RuhejamiM/hand-hygiene-device/README.md

# hand-hygiene-device 
A device that encourages children to wash their hands through play to foster independence as a skill and reward good hygiene habits.

Ethan Bonpin (@eb3326; eb3326@nyu.edu) and Ruhejami Mustari (@RuhejamiM; rm4966@nyu.edu)
