RuhejamiM/hand-hygiene-device/Documentation/Physical Interface.pdf

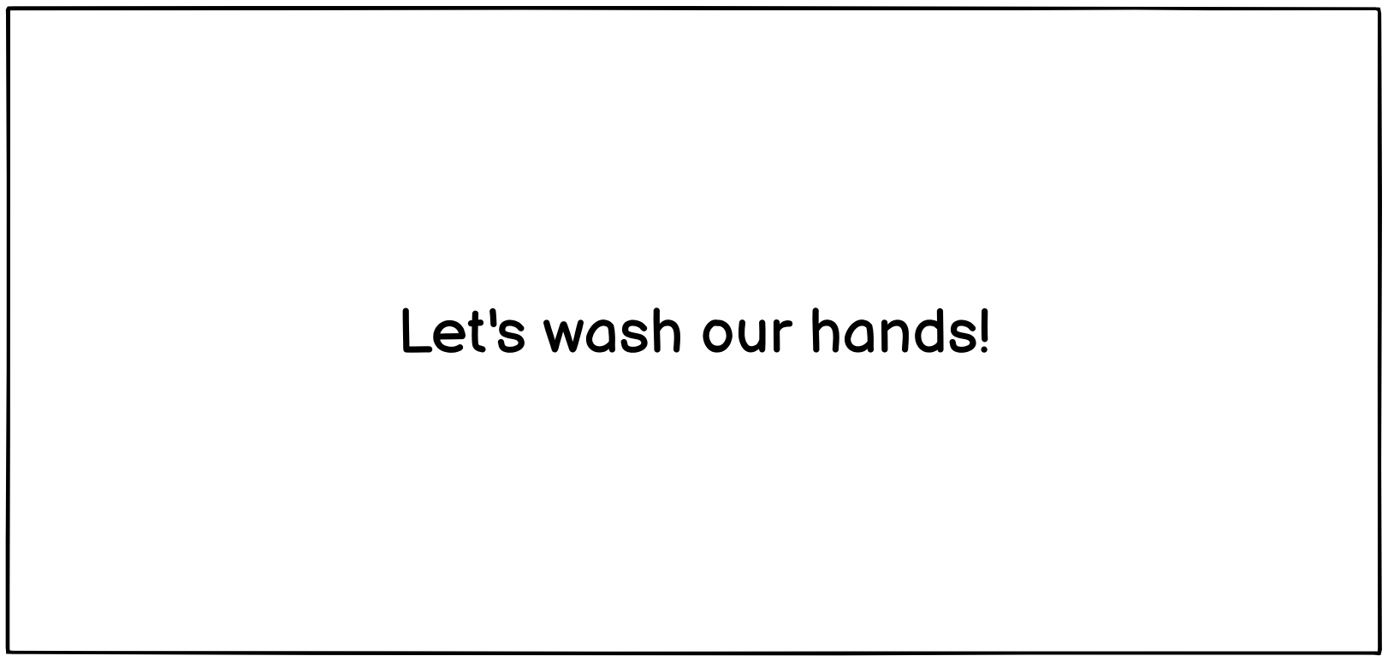
[picture p1: figure]
Let's wash our hands!

Settings

Scroll

Select

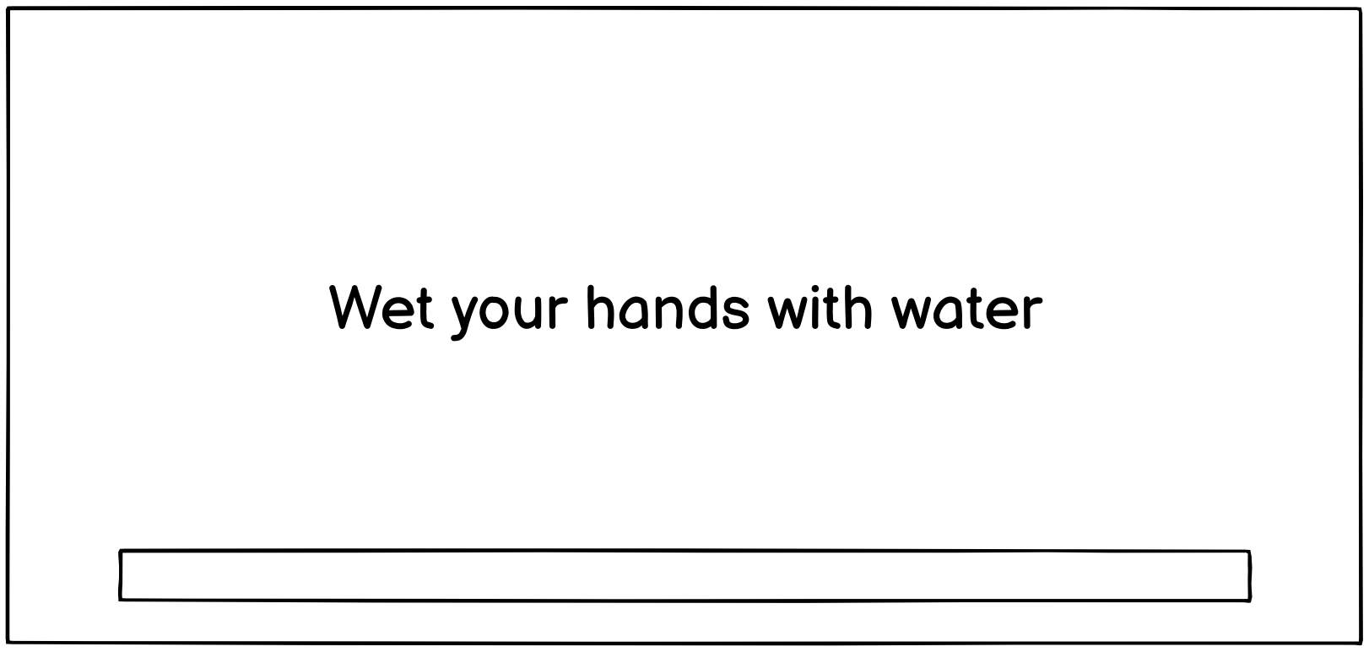
[picture p2: figure]
Wet your hands with water

Scroll

Select

Settings

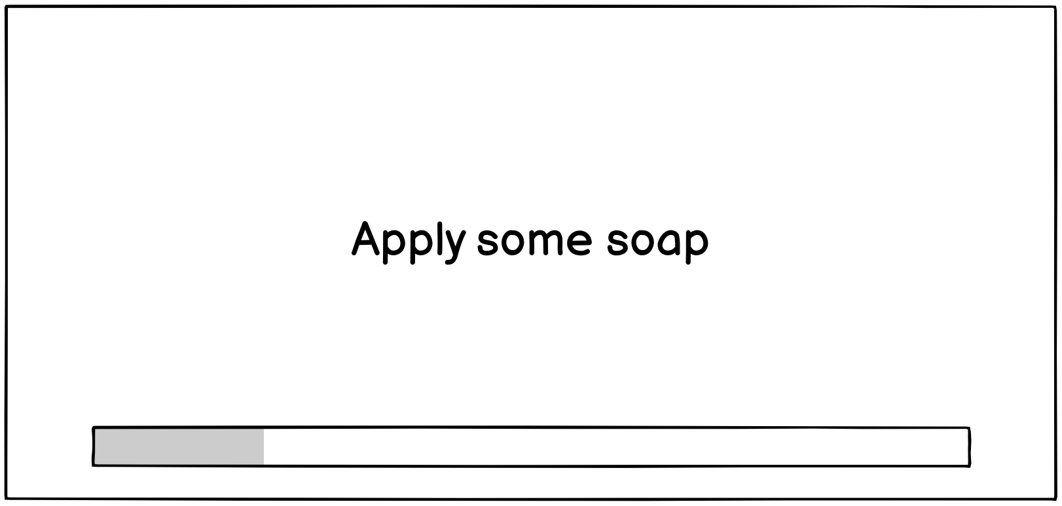
[picture p3: figure]
Apply some soap

Scroll

Select

Settings

Scroll

Select

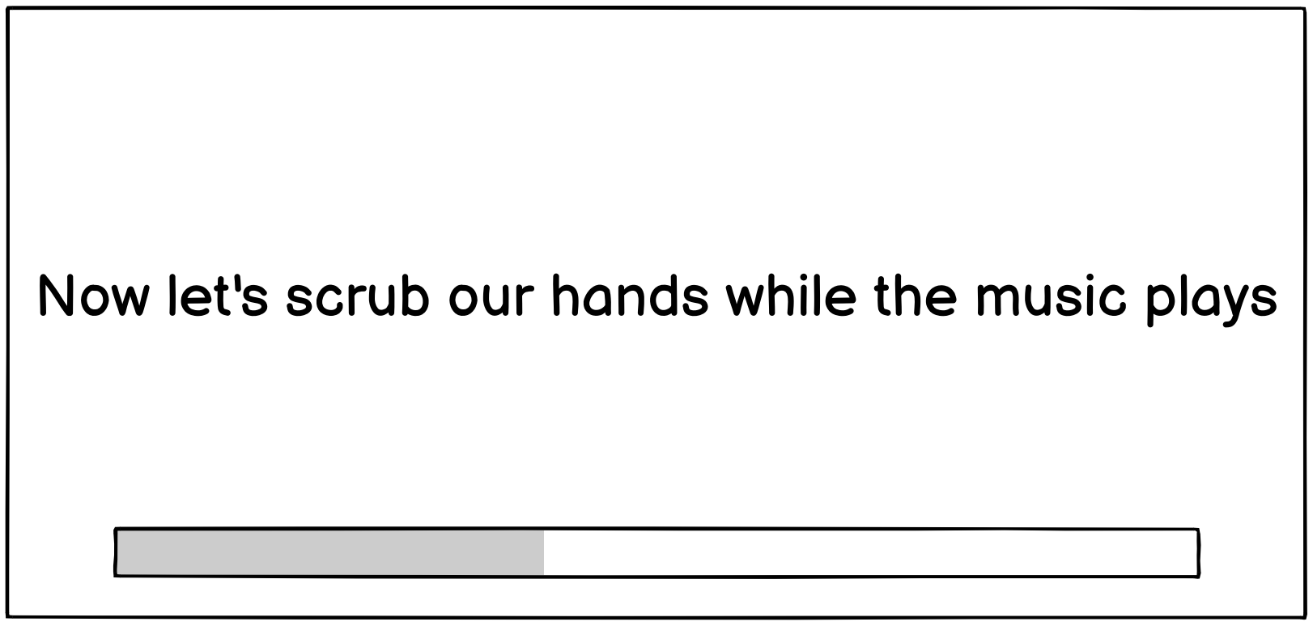
[picture p4: figure]

Now let's scrub our hands while the music plays

Settings

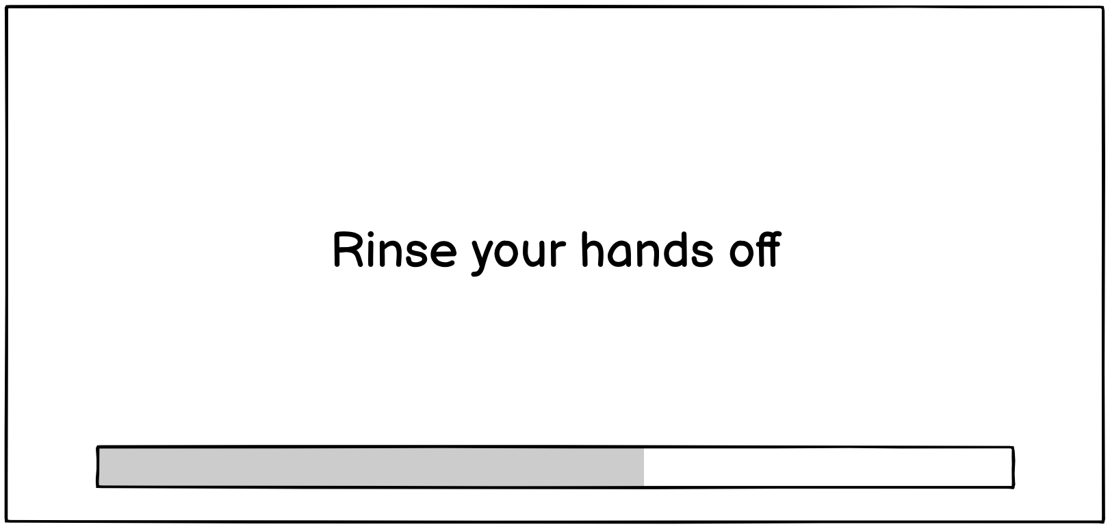
[picture p5: figure]
Rinse your hands off

Scroll

Select

Settings

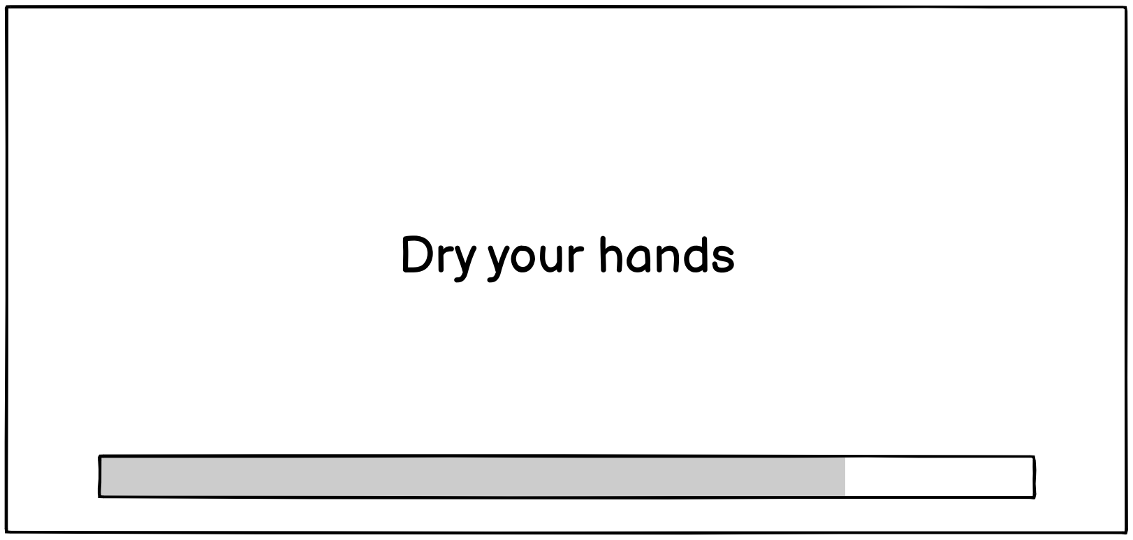
[picture p6: figure]
Dry your hands

Scroll

Select

Settings

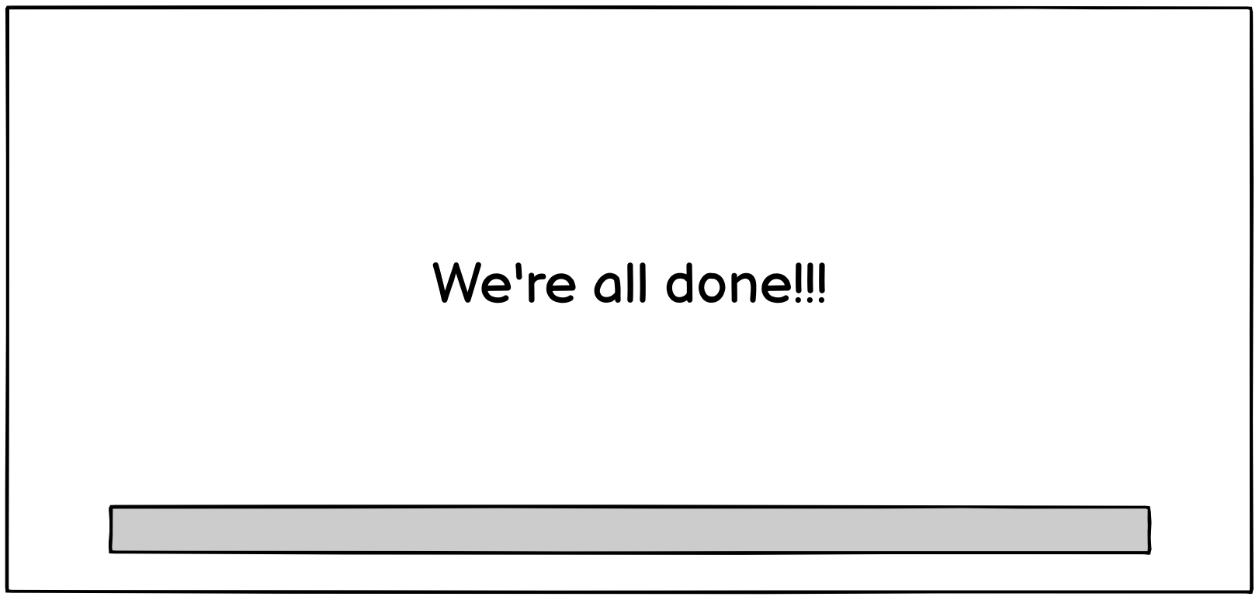
[picture p7: figure]
We're all done!!!

Scroll

Select

Settings

Scroll

Select

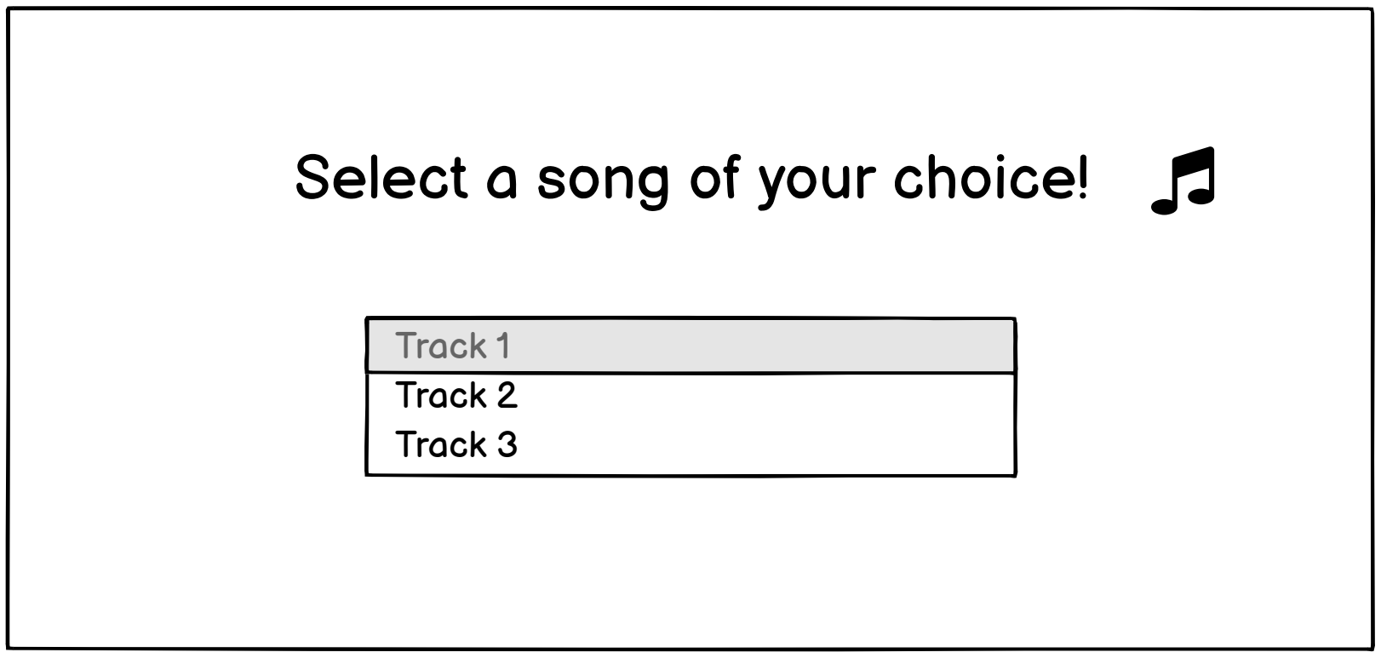
[picture p8: figure]
Track 1 Track 2 Track 3

Settings | Select a song of your choice!

Scroll

Select

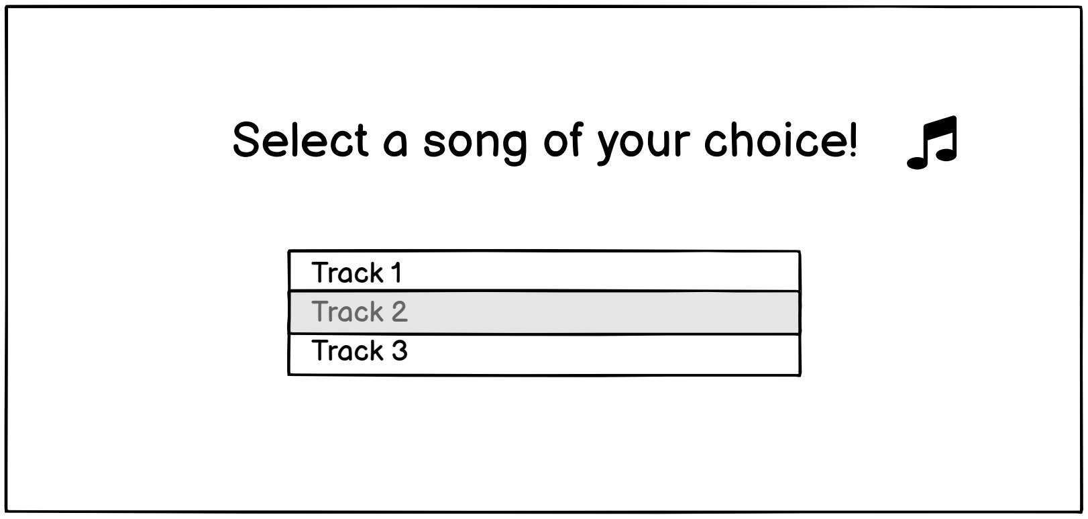
[picture p9: figure]
Track 1 Track 2 Track 3

Settings | Select a song of your choice!

Scroll

Select

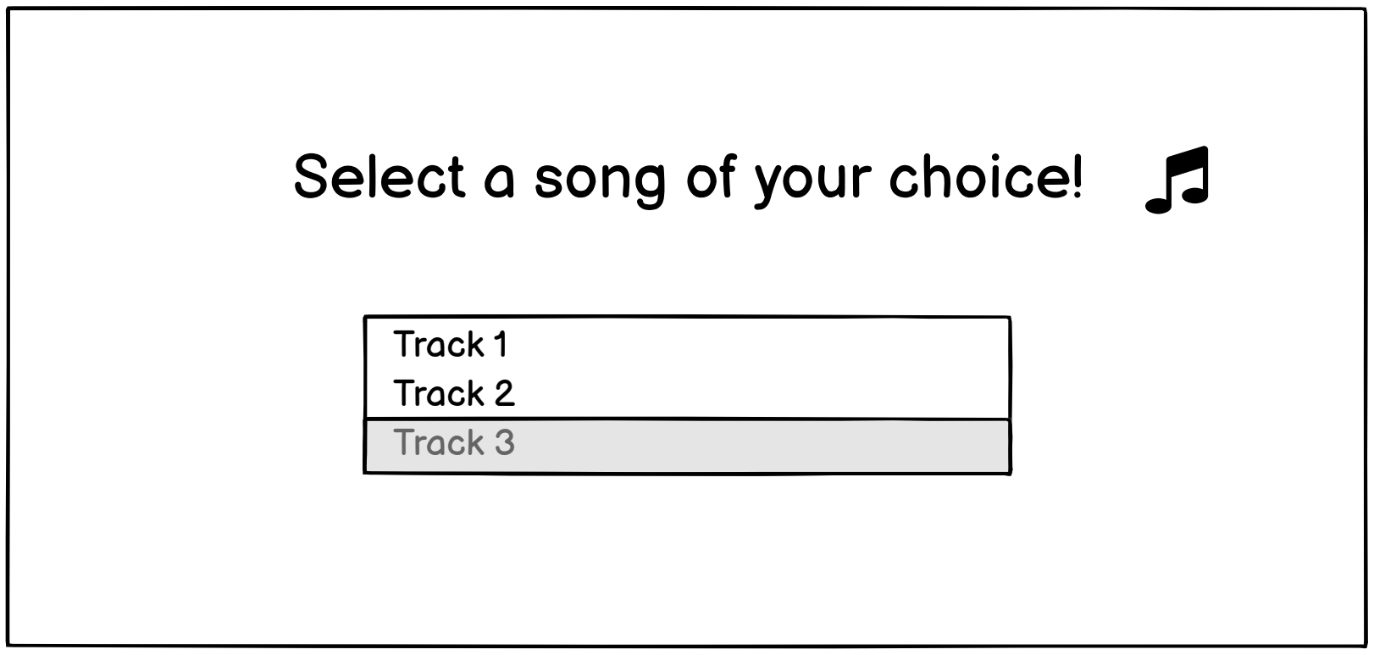
[picture p10: figure]
Track 1 Track 2 Track 3

Settings | Select a song of your choice!
