RuhejamiM/hand-hygiene-device/img/dry_hands.png

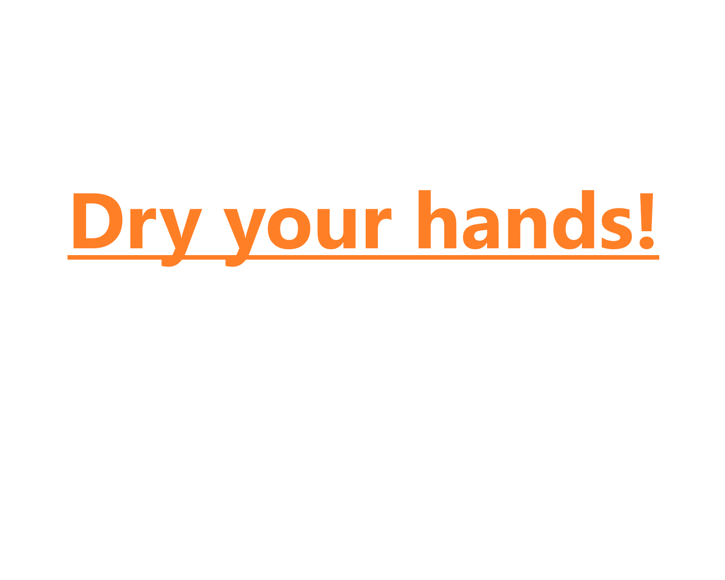
img/dry_hands.png
