RuhejamiM/hand-hygiene-device/img/finished.png

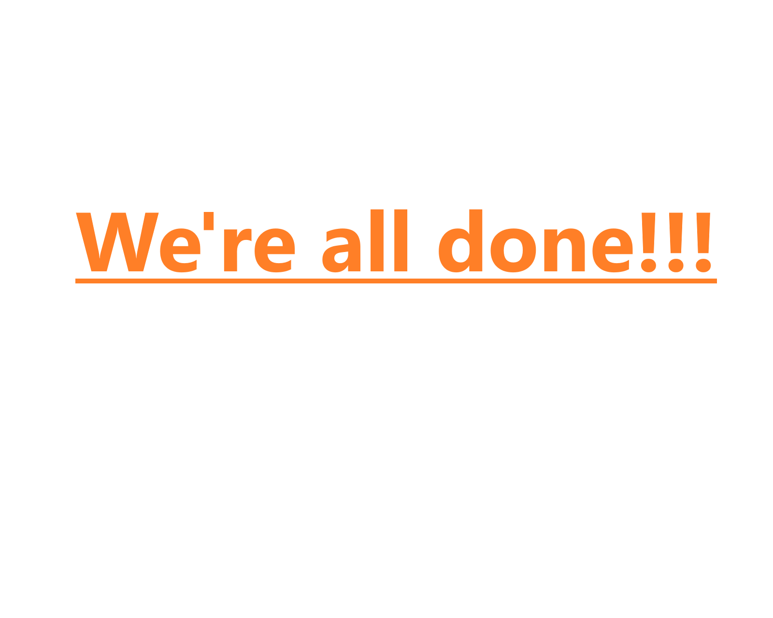
img/finished.png
