RuhejamiM/hand-hygiene-device/img/rinse_hands.png

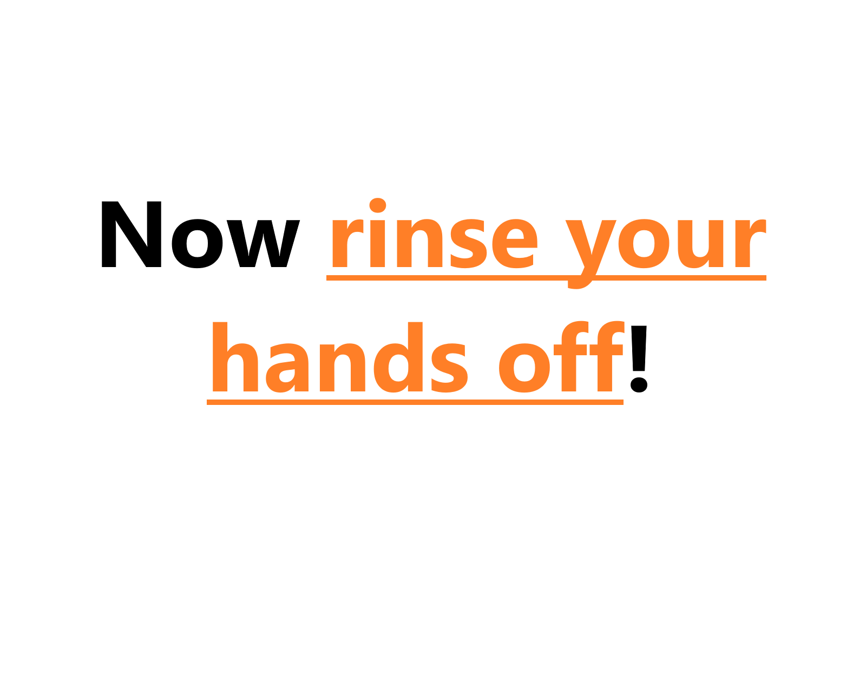
img/rinse_hands.png
