RuhejamiM/hand-hygiene-device/img/scrub_hands.png

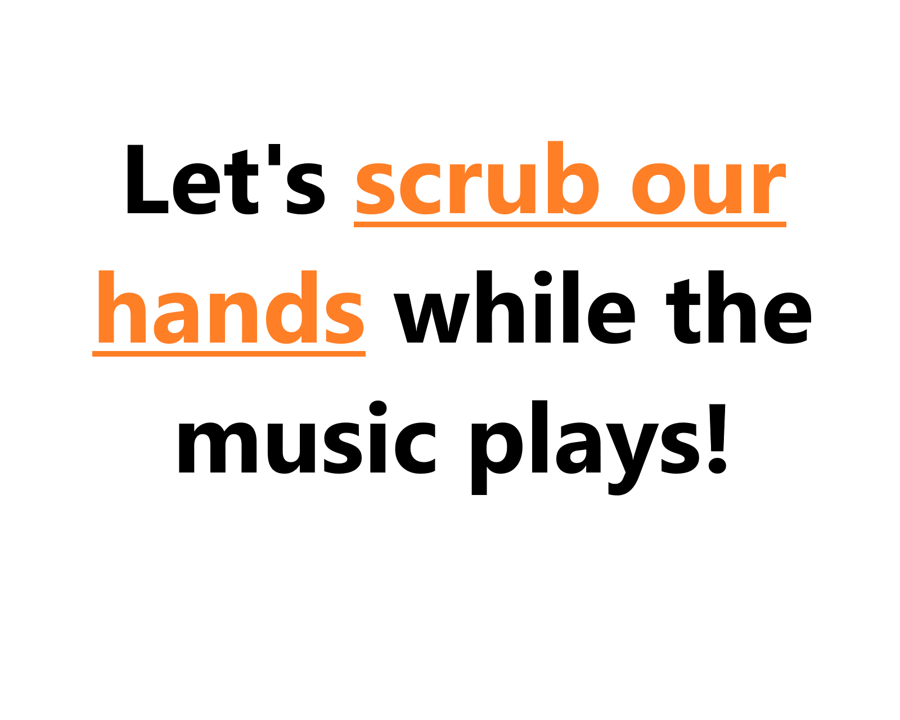
img/scrub_hands.png
