RuhejamiM/hand-hygiene-device/img/settings_main.png

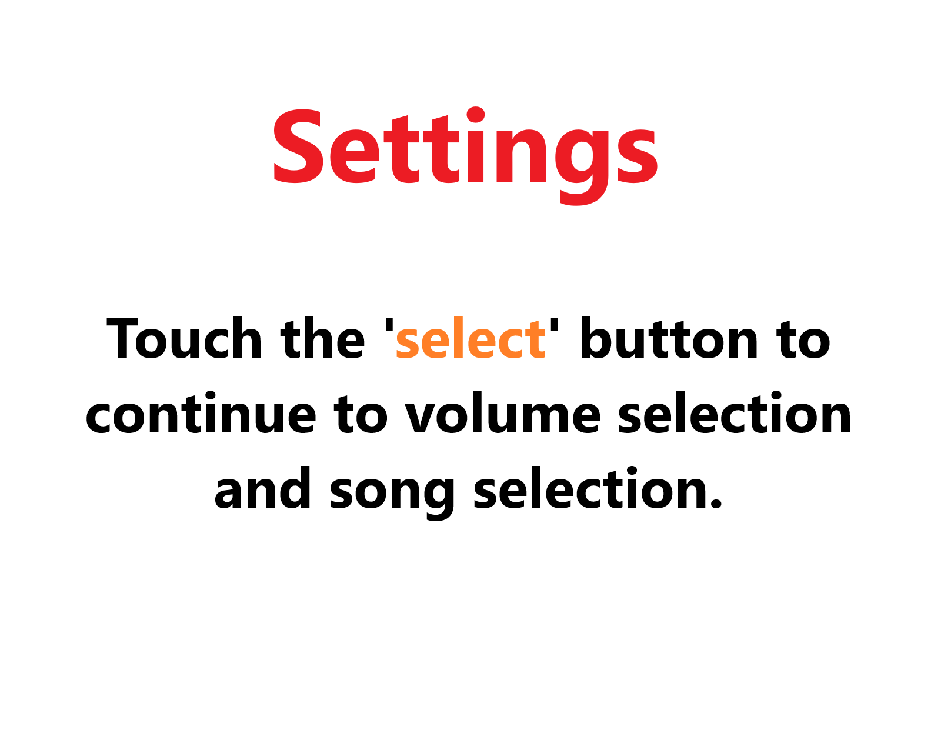
img/settings_main.png
