RuhejamiM/hand-hygiene-device/img/settings_songchoice.png

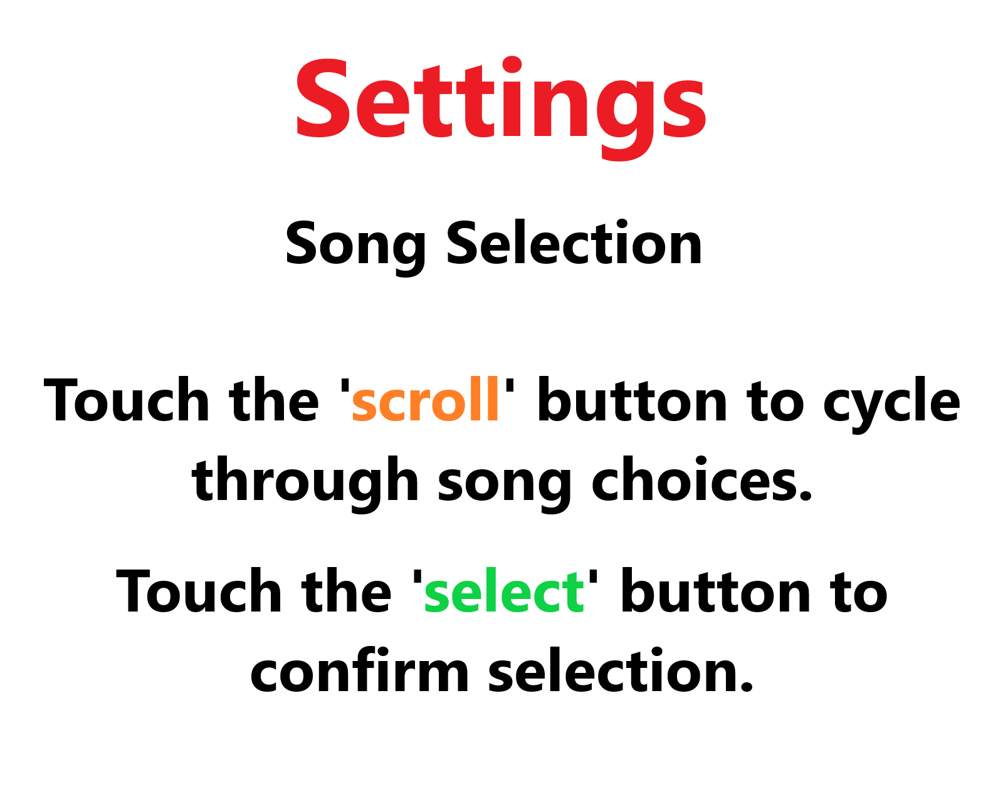
img/settings_songchoice.png
