RuhejamiM/hand-hygiene-device/img/settings_volume.png

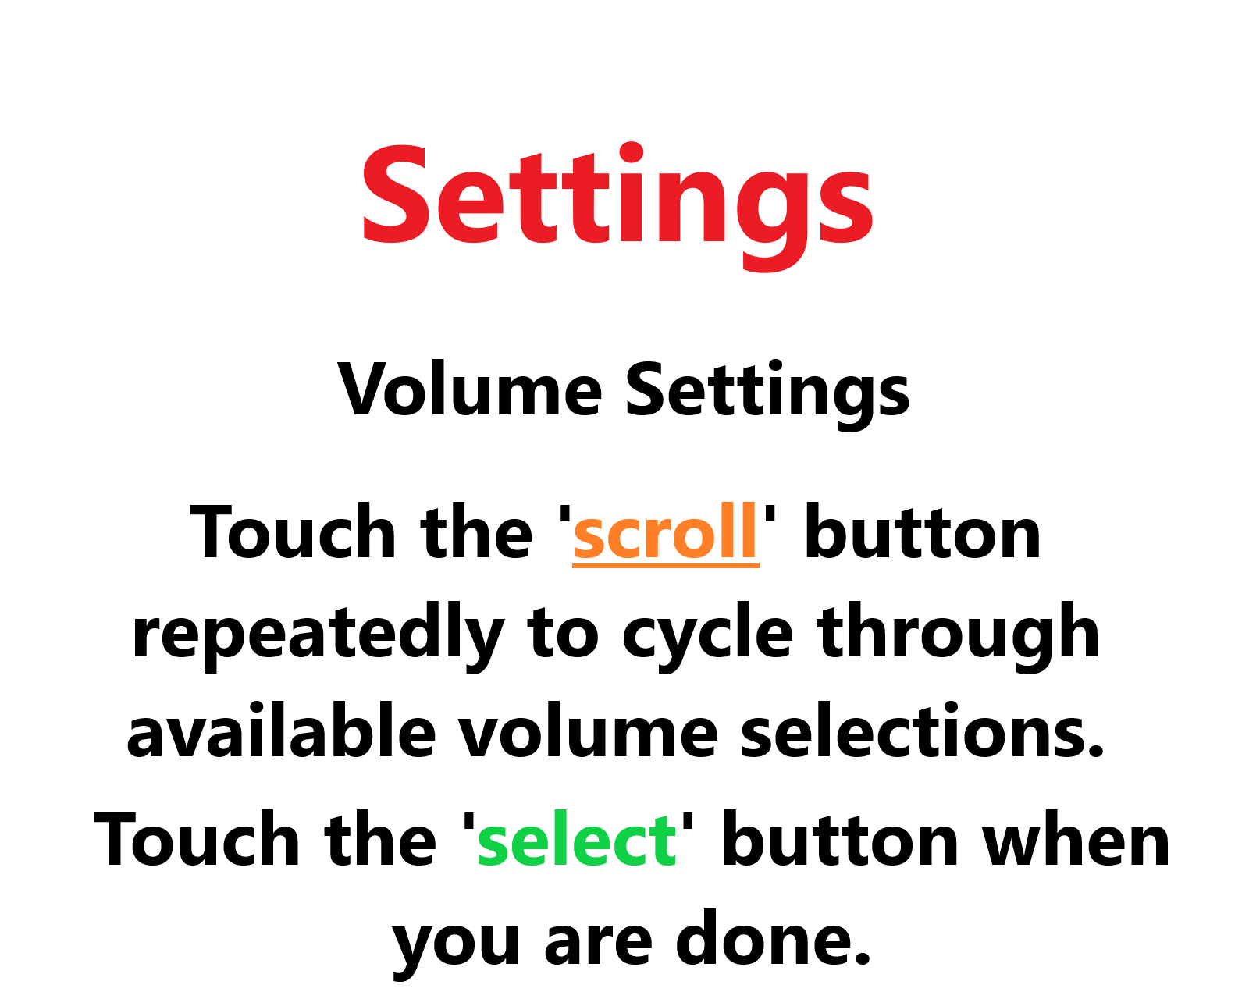
img/settings_volume.png
