RuhejamiM/hand-hygiene-device/img/turn_water_off.png

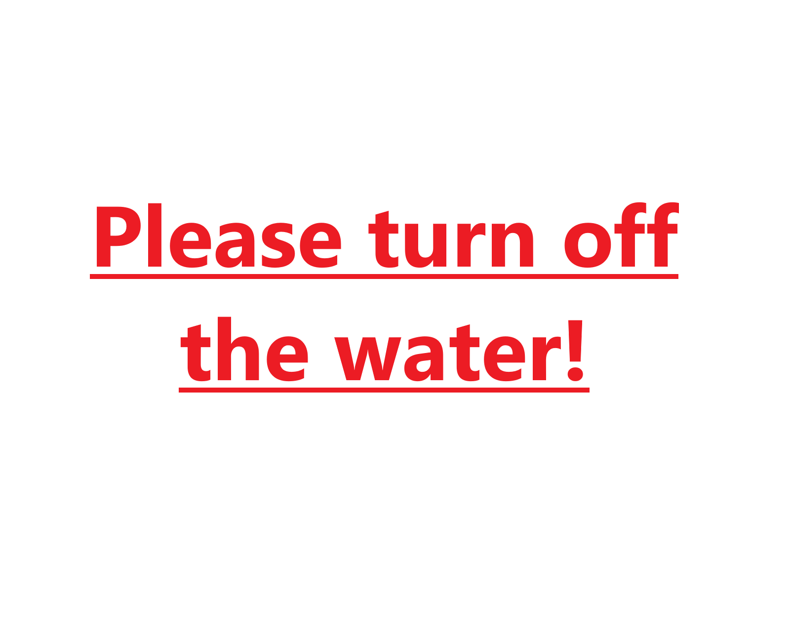
img/turn_water_off.png
