RuhejamiM/hand-hygiene-device/img/welcome.png

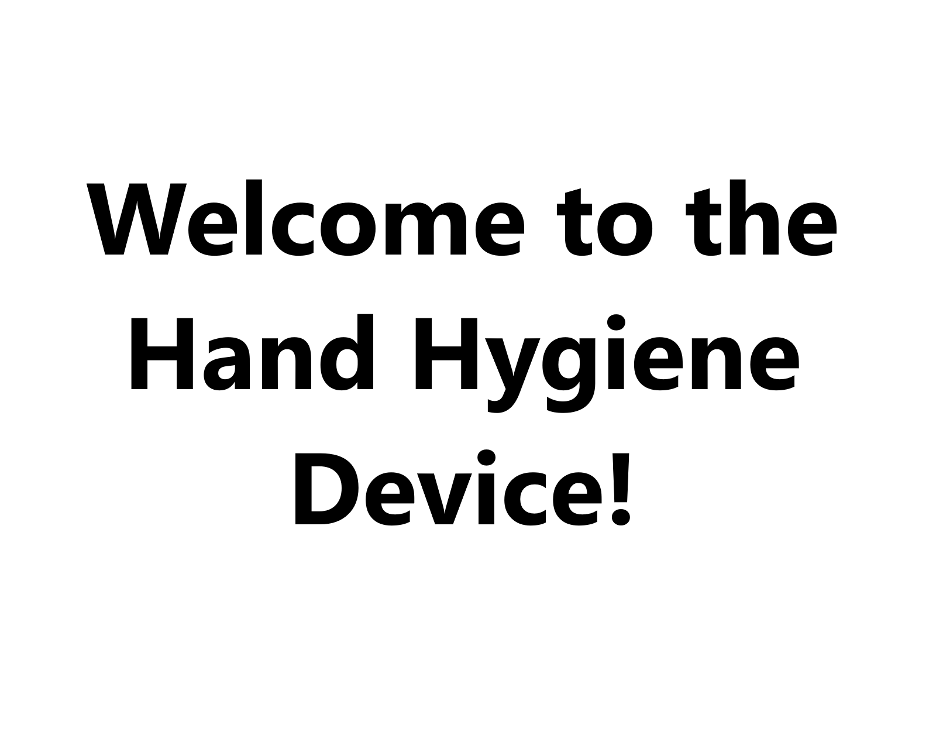
img/welcome.png
