RuhejamiM/hand-hygiene-device/Documentation/New Parts Assignment - Water Flow Sensor.pdf

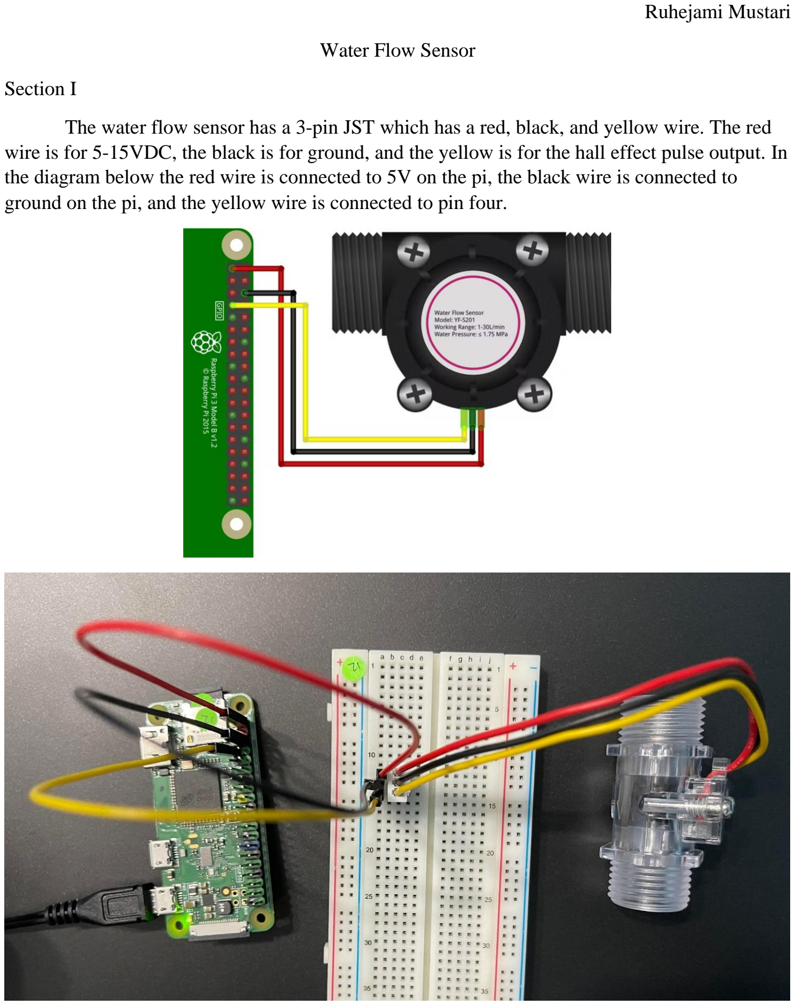
[picture p23: page 1]

Ruhejami Mustari

Water Flow Sensor

Section I

The water flow sensor has a 3-pin JST which has a red, black, and yellow wire. The red wire is for 5-15VDC, the black is for ground, and the yellow is for the hall effect pulse output. In the diagram below the red wire is connected to 5V on the pi, the black wire is connected to ground on the pi, and the yellow wire is connected to pin four.

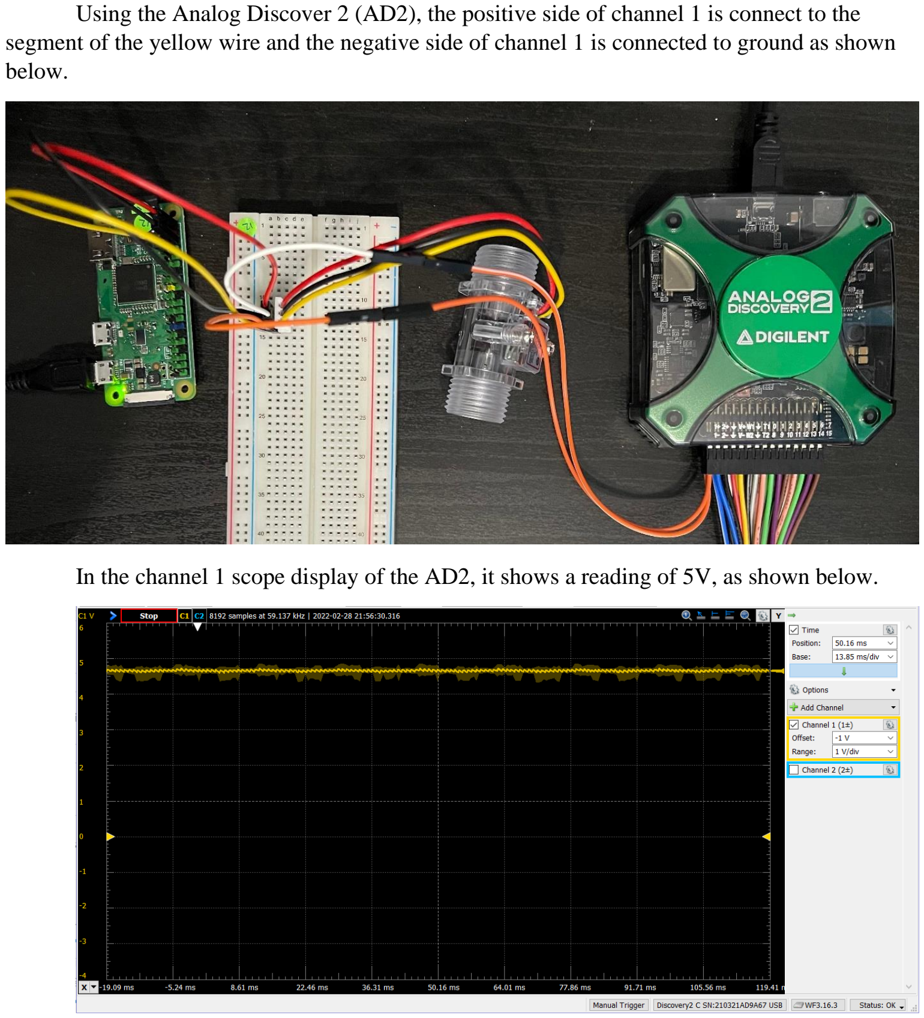
[picture p24: page 2]

Using the Analog Discover 2 (AD2), the positive side of channel 1 is connect to the segment of the yellow wire and the negative side of channel 1 is connected to ground as shown below.

In the channel 1 scope display of the AD2, it shows a reading of 5V, as shown below.

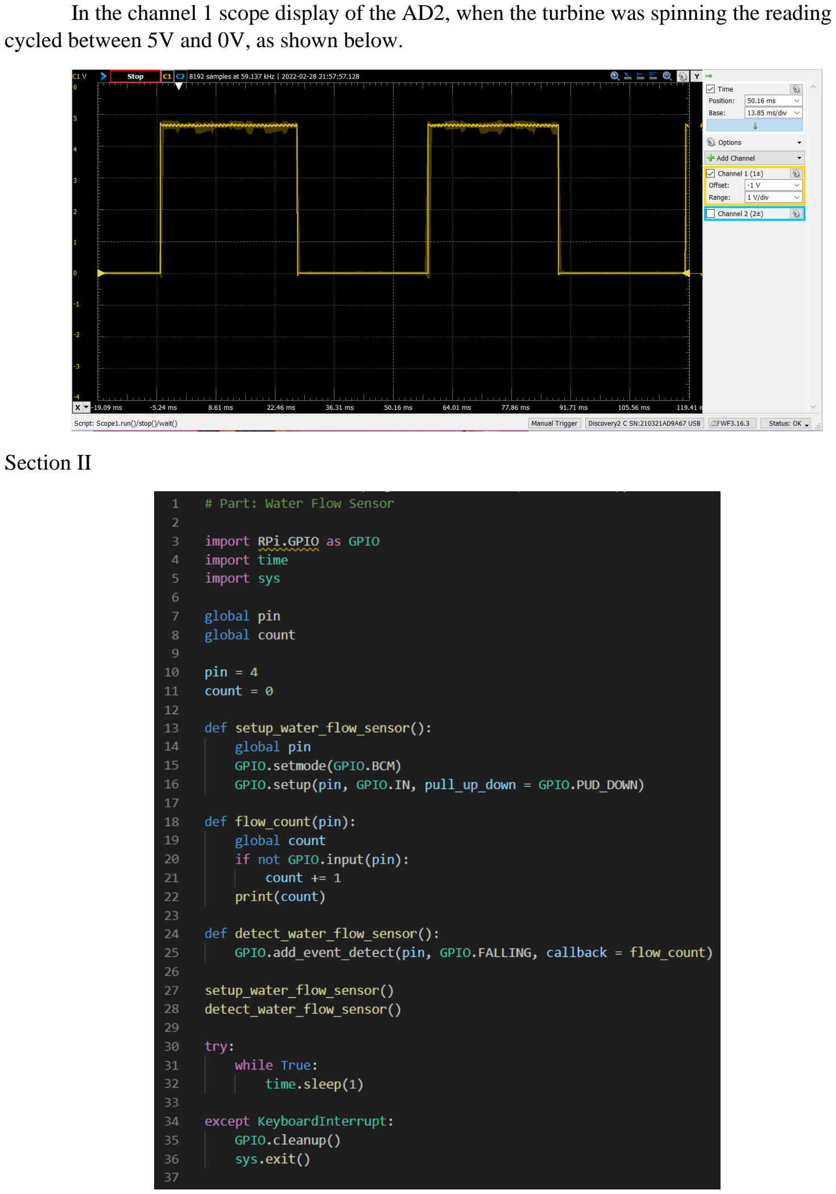
[picture p25: page 3]

In the channel 1 scope display of the AD2, when the turbine was spinning the reading cycled between 5V and 0V, as shown below.

Section II

The necessary imports are made. Then global variable for the pin number and the count are created. The function setup_water_flow_sensor() sets up the pin and sets it up to GPIO/BCM pin four and sets it to pull down. The flow_count() updates the global count variable every time a falling edge is detecting so that the number of times the turbine spins is being kept track of. The detect_water_flow_sensor() detects the falling edge. The setup function is called and then the detect function is called. The try except runs the code continuously until a keyboard interruption is detected, where if it is detected then the pins are cleared and exits the system.

When the script is run the following is displayed on the terminal. Every time the turbine is spun, the count is printed which is being incremented.

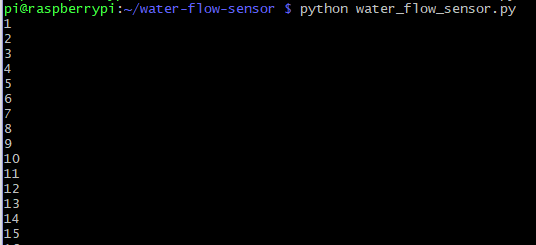
[picture p26: figure]

Section III

The water flow sensor uses a hall effect sensor to detect the turbine’s movements. The hall effect sensor detects the density of the magnetic field around the device. This is a great way to detect the turbine movements without the circuit directly coming in contact with the water. The output is at 5V but when the magnetic flux density exceeds a certain defined limit then the circuit is triggered and represents one revolution of the turbine.

The first image from the AD2 shows channel 1 when there is no movement in the turbine. The second image from the AD2 shows channel 1 when the turbine is spinning. It is noticed that at every revolution the voltage drops to 0V from 5V. The toggle between 5V and 0V shows each revolution of the turbine.

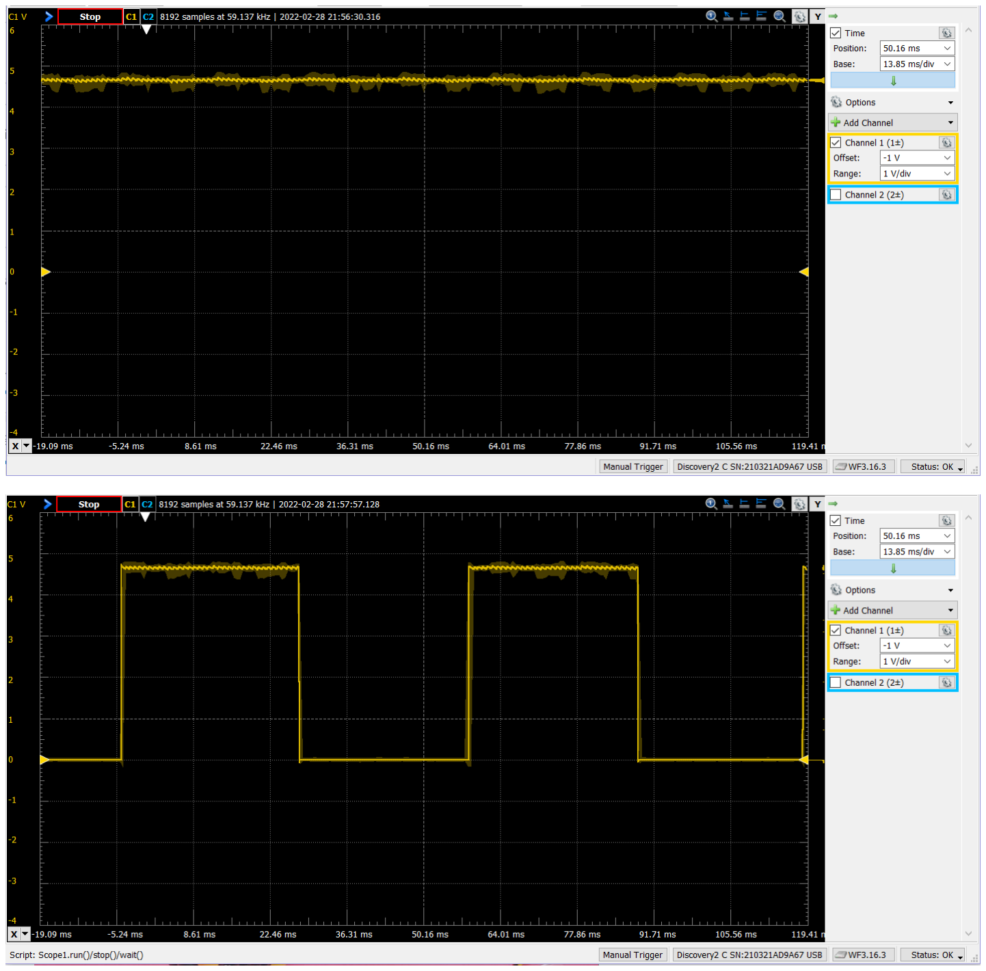
[picture p27: page 5]
