RuhejamiM/hand-hygiene-device/hand-hygiene-case.STL

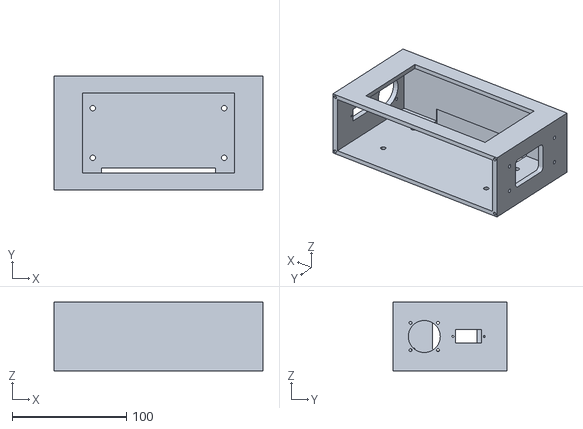
[picture p36: CAD file, 2022-05-09]
hand-hygiene-case.STL
183.0 x 100.0 x 60.0
