RuhejamiM/hand-hygiene-device/hand-hygiene-case-topv2.STL

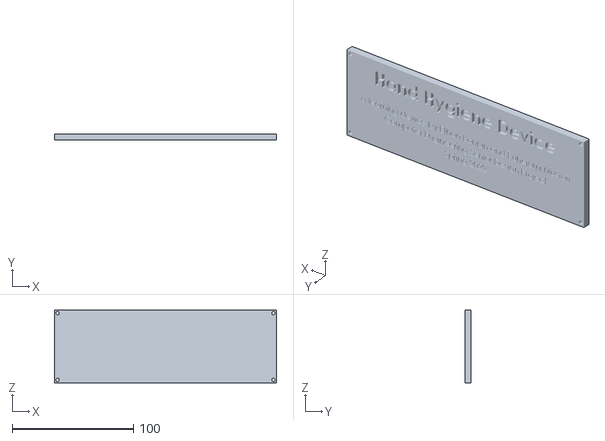
[picture p37: CAD file, 2022-05-09]
hand-hygiene-case-topv2.STL
183.0 x 5.00 x 60.0
