RuhejamiM/hand-hygiene-device/Browser UI.pdf

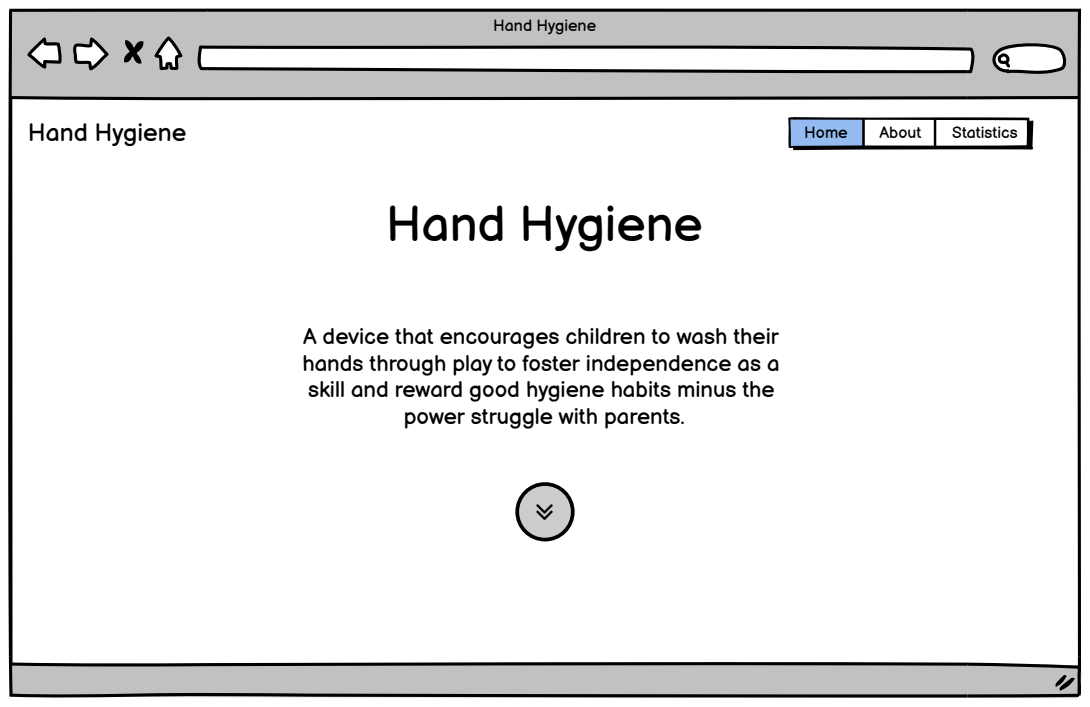
[picture p38: page 1]
Hand Hygiene; Home; About; Statistics

A device that encourages children to wash their
hands through play to foster independence as a
skill and reward good hygiene habits minus the

power struggle with parents.

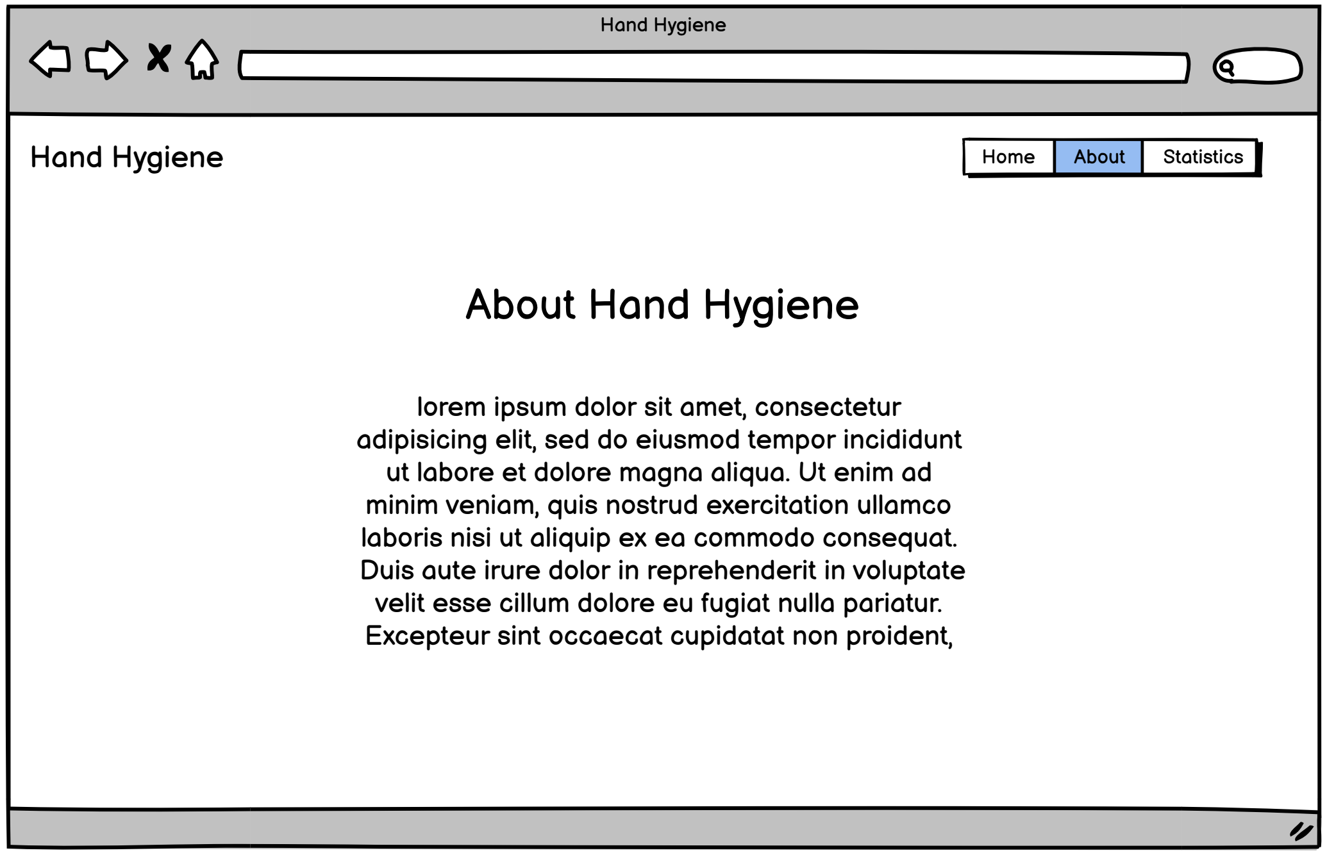
[picture p39: figure]
Hand Hygiene; Home; About; Statistics; About Hand Hygiene; lorem ipsum dolor sit amet, consectetur

adipisicing elit, sed do eiusmod tempor incididunt ut labore et dolore magna aliqua. Ut enim ad minim veniam, quis nostrud exercitation ullamco laboris nisi ut aliquip ex ea commodo consequat. Duis aute irure dolor in reprehenderit in voluptate velit esse cillum dolore eu fugiat nulla pariatur. Excepteur sint occaecat cupidatat non proident,

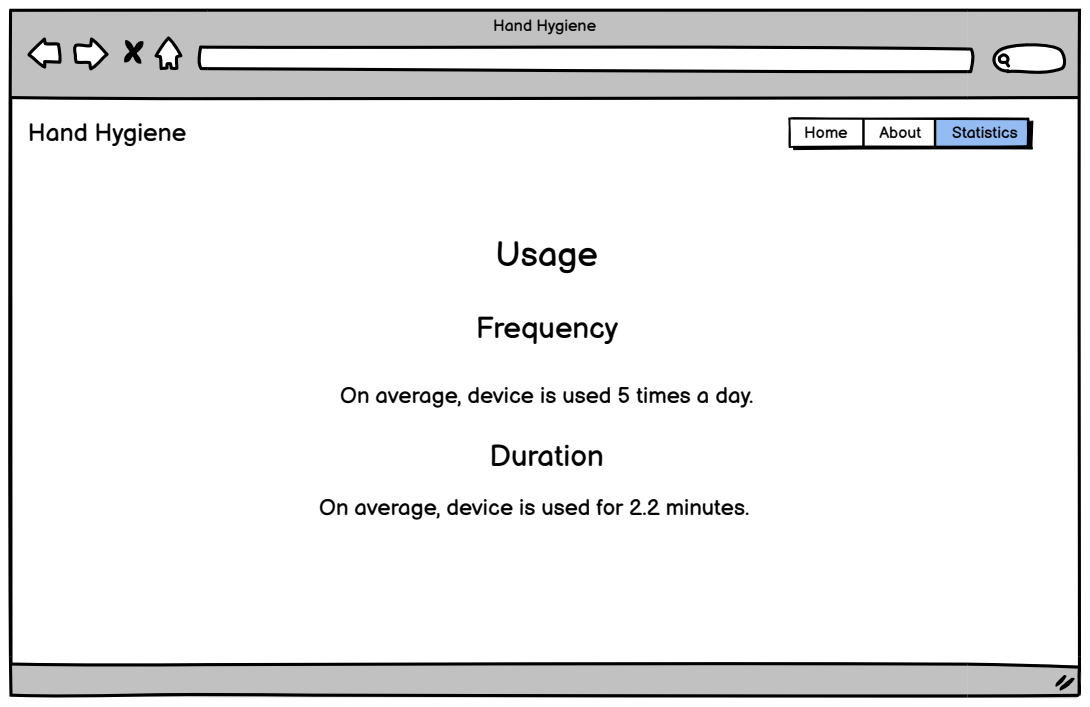
[picture p40: page 3]
Hand Hygiene; Home; About; Statistics; Usage; Frequency; Duration

On average, device is used 5 times a day.

On average, device is used for 2.2 minutes.
