RuhejamiM/hand-hygiene-device/(commit log)

2022-03-02 Added file
    Capacitive touch sensor breakout new project assignment
2022-03-02 Basic test for touch sensor
2022-03-02 New Parts Assignment - Water Flow Sensor
2022-03-09 Create servo.py basic functions for testing
2022-03-09 Create fan.py basic functions for testing
2022-04-06 Update demo.py
    Added demo for the speaker and part of the capacitive touch demo
2022-04-06 Update demo.py
    Added demos for Capacitive Touch Sensor, Bubble System, Water Flow Sensor
2022-04-25 Update demo and hand-hygiene
    Fix typo
    [demo.py, hand-hygiene.py]
2022-04-27 Update demo.py, setup.py, replace hand-hygiene.py
    Fix for python not finding 'hand-hygiene.py' by renaming to 'hand_hygiene.py'
    [demo.py, hand_hygiene.py]
2022-04-27 Update hand_hygiene.py
    Add 'self' to function parameters (bug fix)
    [hand_hygiene.py]
2022-05-09 add 3D Model for project case and lid
    [hand-hygiene-case-topv2.STL, hand-hygiene-case.STL]
2022-05-09 Push current work from Pi
